sonelu/HROS1-Customisation/Head Tilt/Assembly-front view.JPG

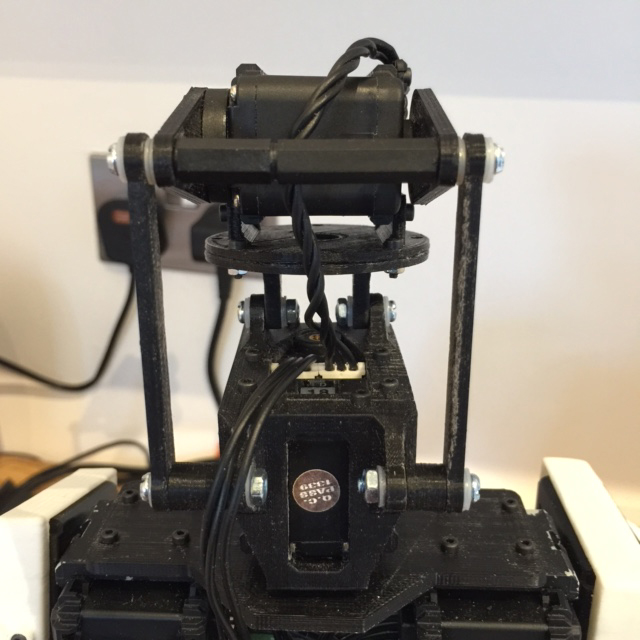
Head Tilt/Assembly-front view.JPG
