sonelu/HROS1-Customisation/Head Tilt/Assembly-side view.JPG

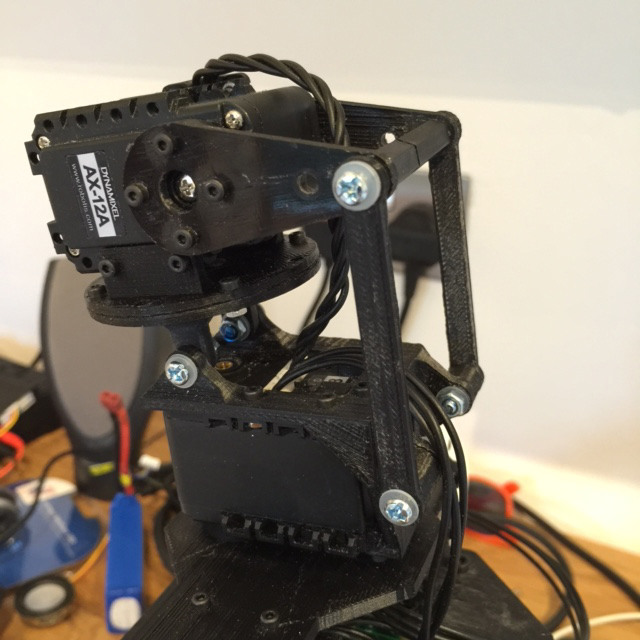
Head Tilt/Assembly-side view.JPG
