sonelu/HROS1-Customisation/Custom Armour Hands/README.md

Custom Armour for Hands
===============

The current HROS1 armour is not very Home 3D Printer friendly and less modular.

This design can be printed with a home 3D printer and with a little care without the need for any support.

Assembly guide included.
