sonelu/HROS1-Customisation/Custom Armour Hands/Claw.FCStd

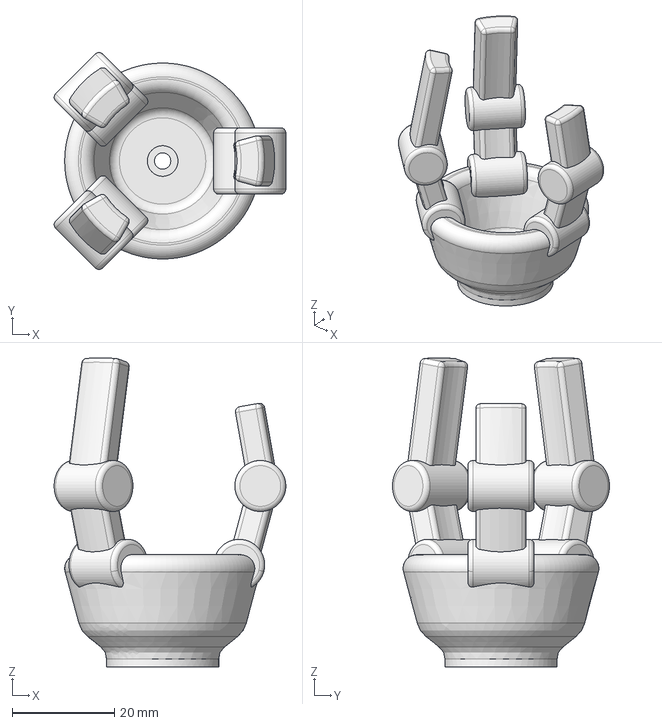
[picture p3: CAD file, 2015-10-23]
Custom Armour Hands/Claw.FCStd
45.4 x 42.5 x 60.5 mm
