sonelu/HROS1-Customisation/Head Tilt/7mm M3 spacer.FCStd

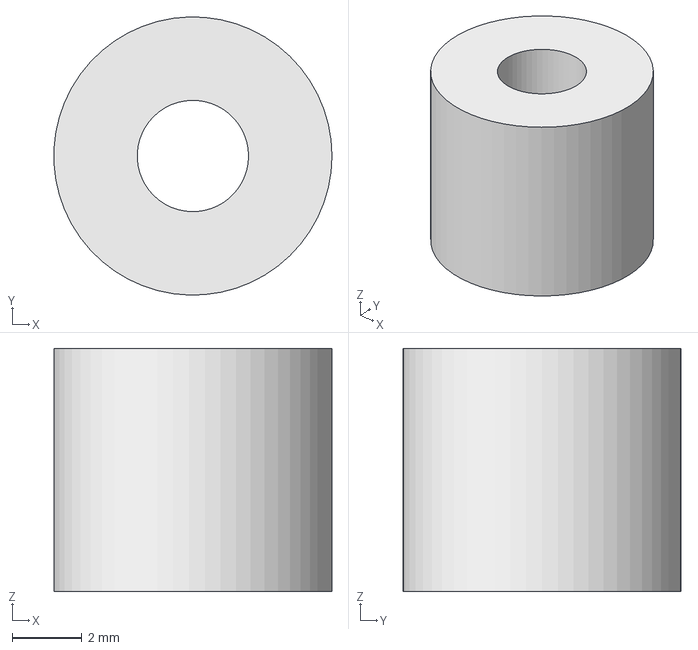
[picture p4: CAD file, 2015-10-28]
Head Tilt/7mm M3 spacer.FCStd
7.99 x 8.00 x 7.00 mm
