sonelu/HROS1-Customisation/Jimmy Head/STEP/Jymmy Head Top v3.1.stp

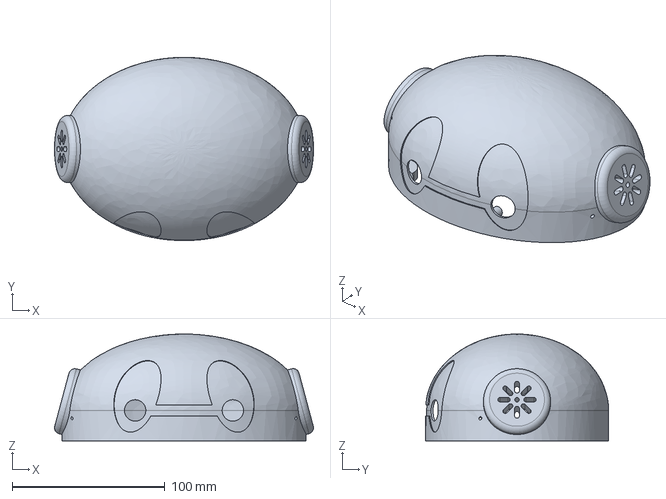
[picture p5: CAD file, 2015-11-10]
Jimmy Head/STEP/Jymmy Head Top v3.1.stp
169.6 x 120.0 x 70.0 mm
