sonelu/HROS1-Customisation/Custom Armour Hands/Hand Cover v2.FCStd

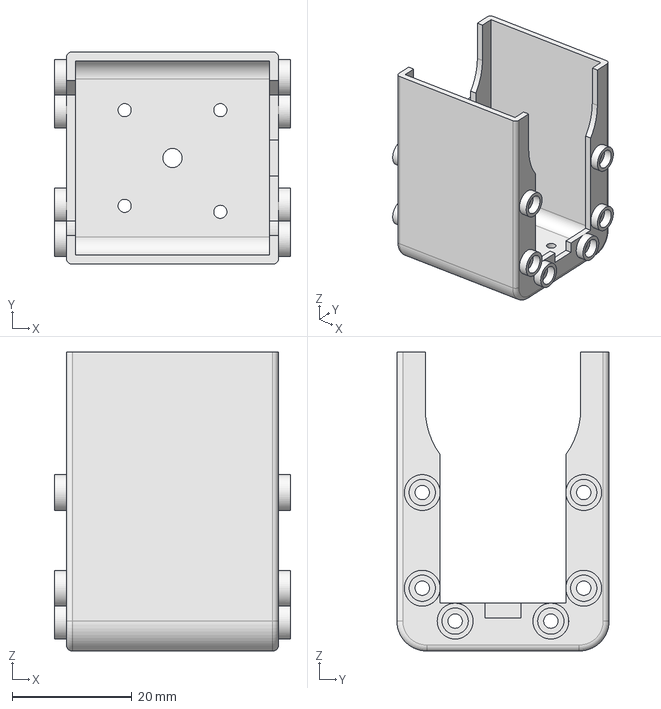
[picture p6: CAD file, 2015-10-23]
Custom Armour Hands/Hand Cover v2.FCStd
39.5 x 35.5 x 50.0 mm
