sonelu/HROS1-Customisation/Head Tilt/Tilt Swing Arm Updated.FCStd

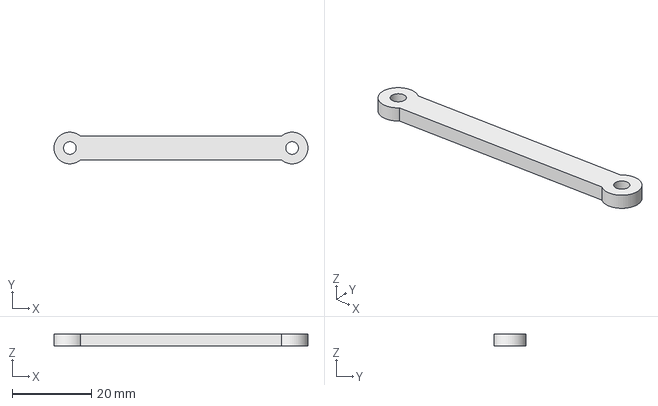
[picture p7: CAD file, 2015-10-28]
Head Tilt/Tilt Swing Arm Updated.FCStd
64.0 x 8.00 x 3.00 mm
