sonelu/HROS1-Customisation/Jimmy Head/STEP/Neck v3.1.stp

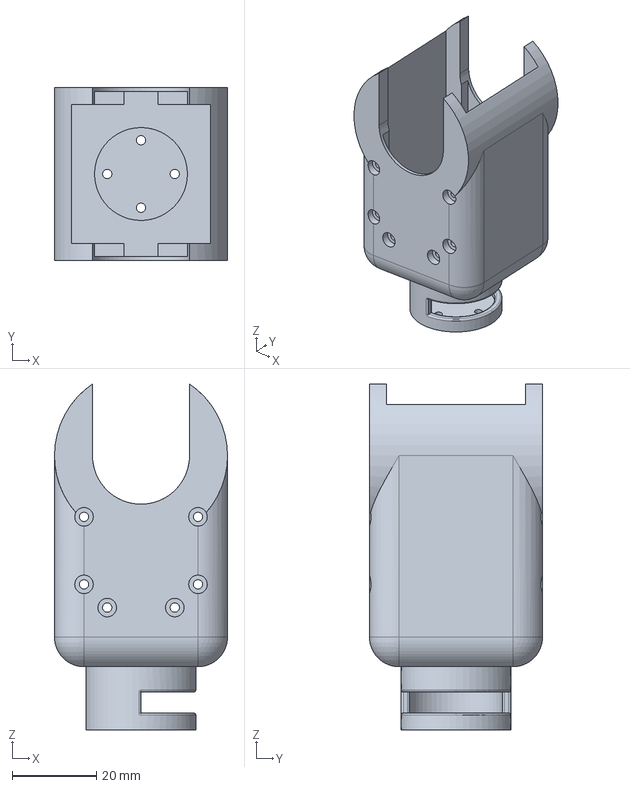
[picture p8: CAD file, 2015-11-10]
Jimmy Head/STEP/Neck v3.1.stp
41.0 x 41.0 x 82.0 mm
