sonelu/HROS1-Customisation/Head Tilt/10mm M3 spacer.FCStd

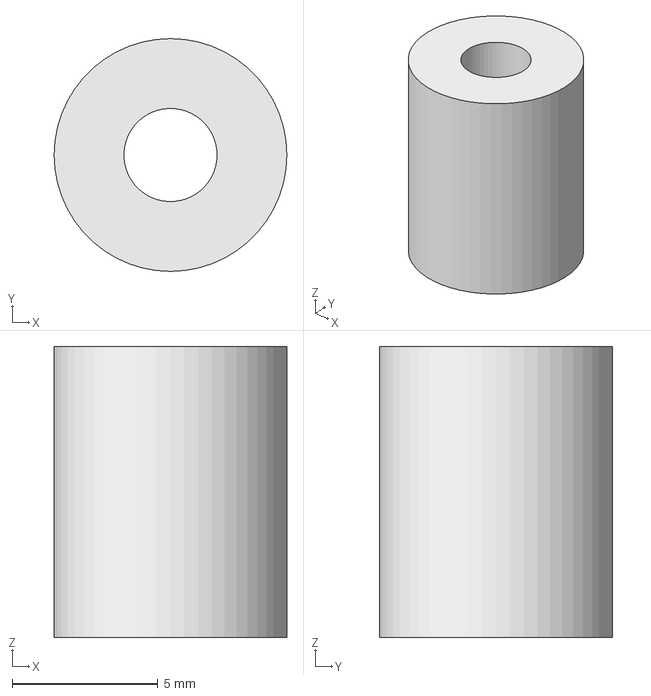
[picture p9: CAD file, 2015-10-28]
Head Tilt/10mm M3 spacer.FCStd
8.00 x 8.00 x 10.0 mm
