sonelu/HROS1-Customisation/Jimmy Head/STEP/P1 updated.stp

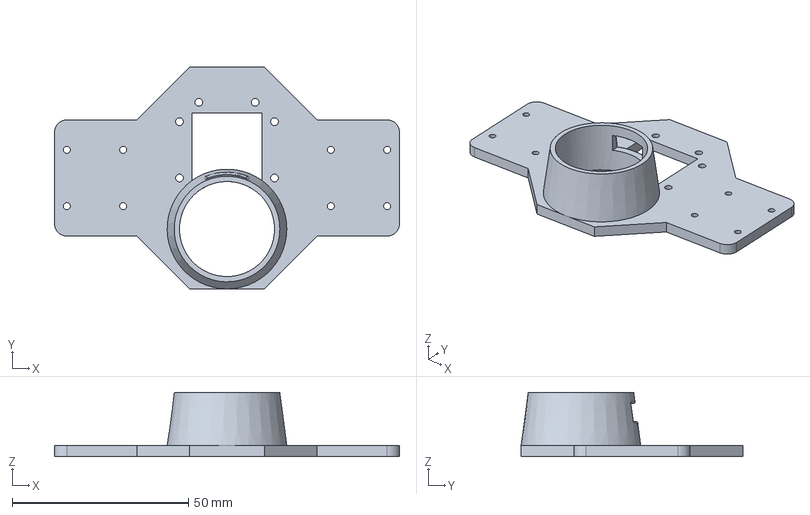
[picture p10: CAD file, 2015-11-10]
Jimmy Head/STEP/P1 updated.stp
98.0 x 63.0 x 18.2 mm
