sonelu/HROS1-Customisation/Head Tilt/Tilt Servo Bracket Updated.FCStd

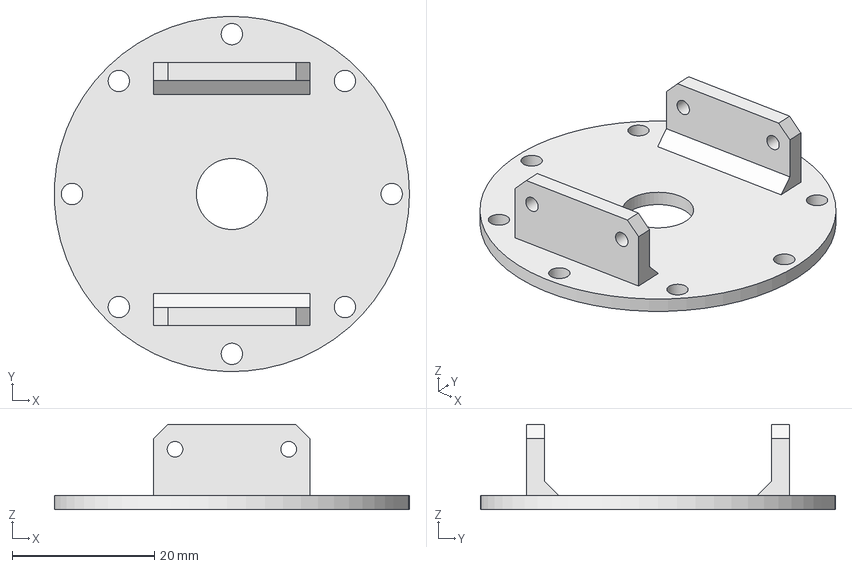
[picture p11: CAD file, 2015-10-28]
Head Tilt/Tilt Servo Bracket Updated.FCStd
50.0 x 50.0 x 12.0 mm
