sonelu/HROS1-Customisation/Jimmy Head/STEP/Head Joint v2.stp

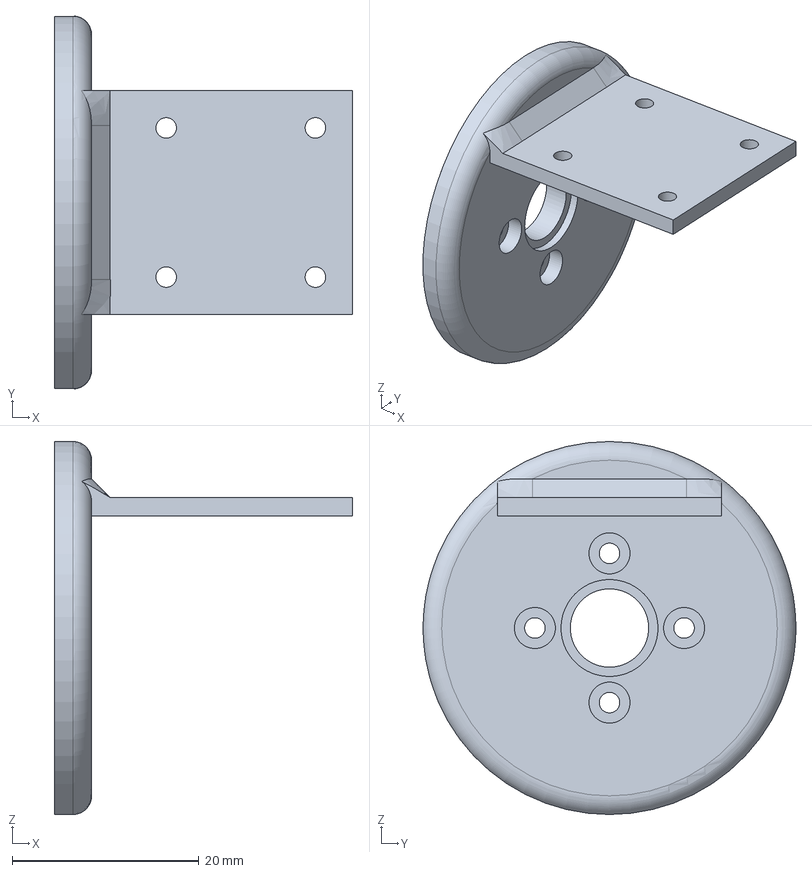
[picture p12: CAD file, 2015-11-10]
Jimmy Head/STEP/Head Joint v2.stp
32.0 x 40.0 x 40.0 mm
