sonelu/HROS1-Customisation/Head Tilt/Tilt Plate Bracket Updated.FCStd

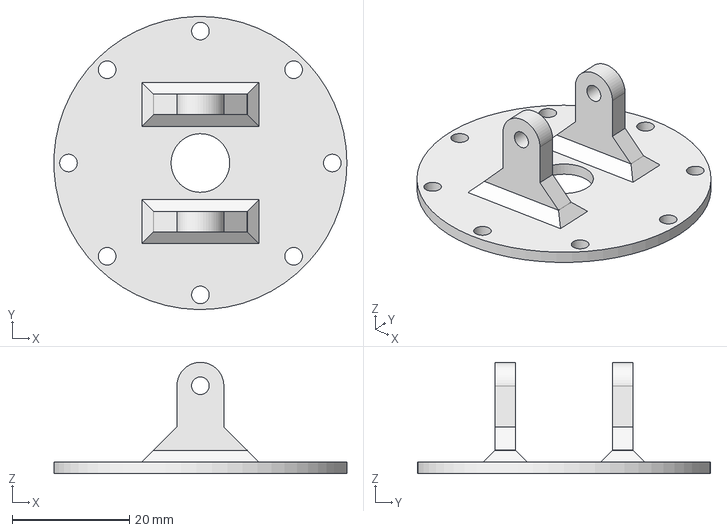
[picture p13: CAD file, 2015-10-27]
Head Tilt/Tilt Plate Bracket Updated.FCStd
50.0 x 50.0 x 19.0 mm
