sonelu/HROS1-Customisation/Jimmy Head/STEP/Speaker Cap.stp

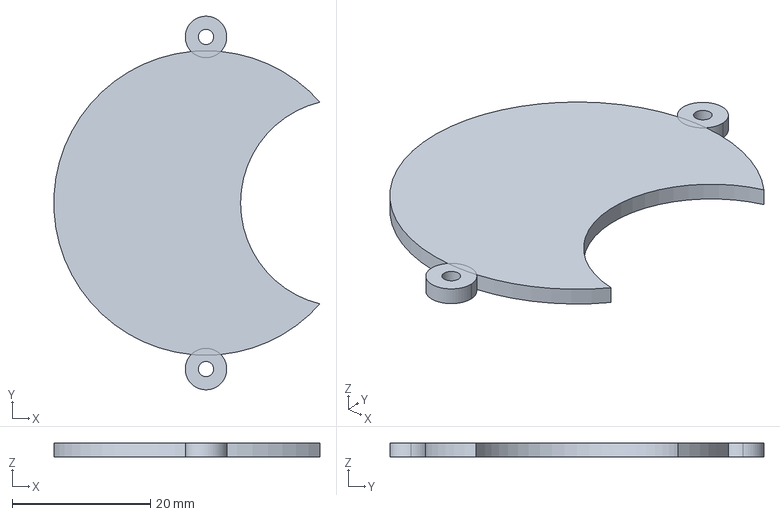
[picture p14: CAD file, 2015-11-10]
Jimmy Head/STEP/Speaker Cap.stp
38.4 x 54.0 x 2.00 mm
