sonelu/HROS1-Customisation/Jimmy Head/STEP/Jymmy Head Bottom v3.1.stp

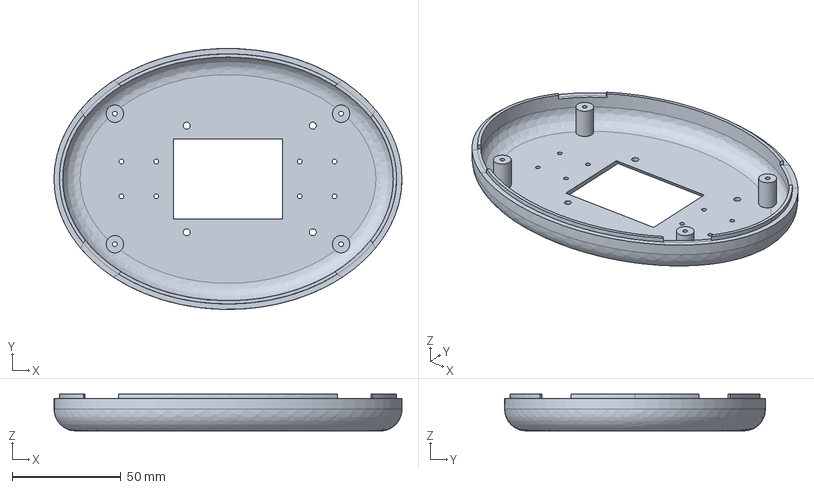
[picture p15: CAD file, 2015-11-10]
Jimmy Head/STEP/Jymmy Head Bottom v3.1.stp
160.0 x 119.9 x 17.0 mm
