sonelu/HROS1-Customisation/(list of files, cad)

Other CAD files:
Custom Armour Hands/Claw.stl
Custom Armour Hands/Hand Cover v2.stl
Head Tilt/10mm M3 spacer.stl
Head Tilt/7mm M3 spacer.stl
Head Tilt/Tilt Plate Bracket Updated.stl
Head Tilt/Tilt Servo Bracket Updated.stl
Head Tilt/Tilt Swing Arm Updated.stl
Jimmy Head/FreeCad/Head Joint v2.FCStd
Jimmy Head/FreeCad/Jymmy Head Bottom v3.1.FCStd
Jimmy Head/FreeCad/Jymmy Head Top v3.1.FCStd
Jimmy Head/FreeCad/Neck v3.1.FCStd
Jimmy Head/FreeCad/P1 updated.FCStd
Jimmy Head/FreeCad/Speaker Cap.FCStd
Jimmy Head/STL/Head Joint v2.stl
Jimmy Head/STL/Jymmy Head Bottom v3.1.stl
Jimmy Head/STL/Neck v3.1.stl
Jimmy Head/STL/P1 updated.stl
Jimmy Head/STL/Speaker Cap.stl
