sonelu/HROS1-Customisation/(commit log)

2015-10-27 Head Tilt customisation added
    [Head Tilt Thin Lever Updated.FCStd, Head Tilt Thin Lever Updated.stl, Head Tilt Under Updated.FCStd, Head Tilt Under Updated.stl]
2015-10-27 Updated structure and added README
    [Claw.FCStd, Claw.stl, Hand Cover v2.FCStd, Hand Cover v2.stl]
2015-10-28 Added Tilt Servo Bracket, Extended the Arms, added spacers, pictures
    [10mm M3 spacer.FCStd, 10mm M3 spacer.stl, 7mm M3 spacer.FCStd, 7mm M3 spacer.stl, Head Tilt Thin Lever Updated.FCStd, Head Tilt Thin Lever Updated.stl, Tilt Plate Bracket Updated.FCStd, Tilt Plate Bracket Updated.stl]
2015-10-31 Added assembly guide
